I-Grebot/elec_igreplane/doc/pictures/backplane_boards.png

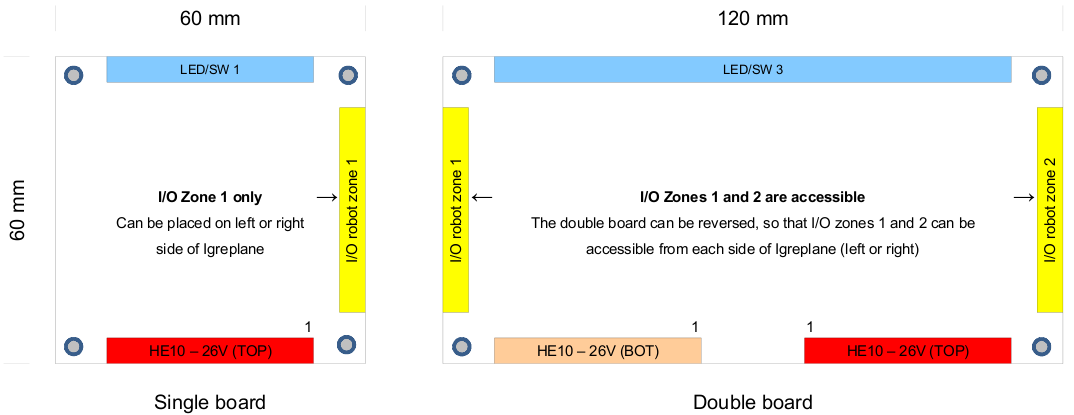
doc/pictures/backplane_boards.png
