I-Grebot/elec_igreplane/doc/pictures/backplane_connector_pinout.png

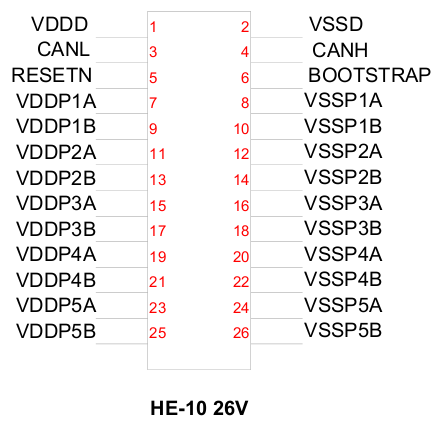
doc/pictures/backplane_connector_pinout.png
