I-Grebot/elec_igreplane/doc/pictures/backplane_layout.png

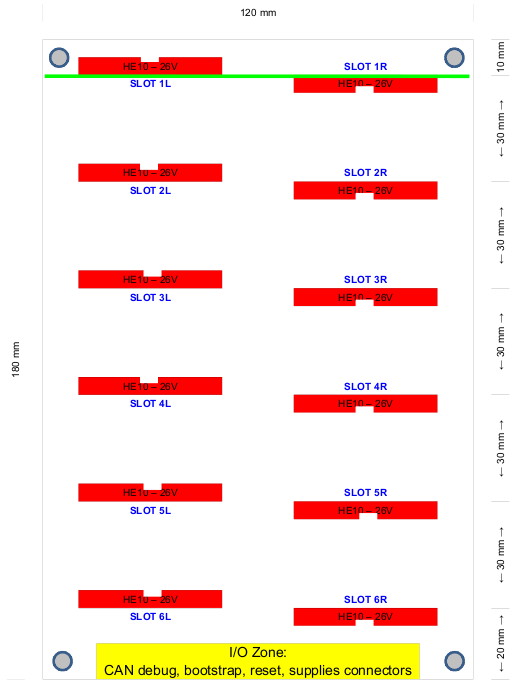
doc/pictures/backplane_layout.png
