I-Grebot/elec_igreplane/pic/eurobot.bmp

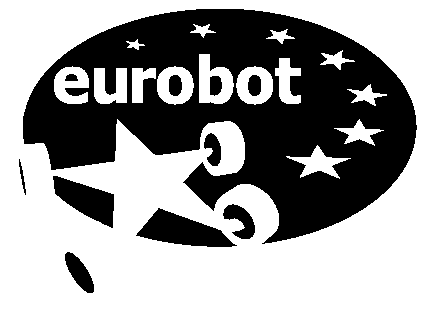
pic/eurobot.bmp
