I-Grebot/elec_igreplane/doc/igreplane_specifications.ods

Sheet: Backplane_layout
IGREBOT 2012
Backplane layout
Drawing grid is 5 mm
 |  | 120 mm
 | 180 mm |  |  |  |  | 10 mm | Notes: | The white rectangle at the connector's top represent the HE-10 slot
 |  |  | HE10 – 26V |  | SLOT 1R |  |  | The board's HE-10 connectors are female
 |  |  | SLOT 1L |  | HE10 – 26V | ← 30 mm → |  | The green line represent a double size board and its position when slotted into the backplane
 |  |  |  |  |  |  |  | The four grey dots represent the Igreplane board holes
 |  |  |  |  |  |  |  |  | located in each corner at 5mm from both edges and with a diameter of 5mm
 |  |  | HE10 – 26V |  | SLOT 2R
 |  |  | SLOT 2L |  | HE10 – 26V | ← 30 mm →
 |  |  | HE10 – 26V |  | SLOT 3R
 |  |  | SLOT 3L |  | HE10 – 26V | ← 30 mm →
 |  |  | HE10 – 26V |  | SLOT 4R
 |  |  | SLOT 4L |  | HE10 – 26V | ← 30 mm →
 |  |  | HE10 – 26V |  | SLOT 5R
 |  |  | SLOT 5L |  | HE10 – 26V | ← 30 mm →
 |  |  | HE10 – 26V |  | SLOT 6R
 |  |  | SLOT 6L |  | HE10 – 26V | ← 20 mm →
 |  |  |  | I/O Zone:
 |  |  |  | CAN debug, bootstrap, reset, supplies connectors

Sheet: Backplane_connector
IGREBOT 2012
Backplane connector
 | Pinout: |  |  |  |  |  |  |  |  |  | Conventions: |  |  | VSS* : Negative rail of power supply
 |  |  |  |  |  |  |  |  |  |  |  |  |  | VDD* : Positive rail of power supply
 |  |  | VDDD |  |  | 1 | 2 |  | VSSD |  |  |  |  | *N : Indicates a digital signal active low
 |  |  | CANL |  |  | 3 | 4 |  | CANH
 |  | RESETN |  |  |  | 5 | 6 |  |  | BOOTSTRAP
 |  |  |  | VDDP1A |  | 7 | 8 | VSSP1A |  |  | Parts references
 |  |  |  | VDDP1B |  | 9 | 10 | VSSP1B
 |  |  |  | VDDP2A |  | 11 | 12 | VSSP2A |  |  |  | * Female header for backbone
 |  |  |  | VDDP2B |  | 13 | 14 | VSSP2B |  |  |  |  | Manufacturer |  | WUERTH ELEKTRONIK
 |  |  |  | VDDP3A |  | 15 | 16 | VSSP3A |  |  |  |  | Serie |  | WR-PHD
 |  |  |  | VDDP3B |  | 17 | 18 | VSSP3B |  |  |  |  | Description |  | 2.54MM DUAL S. HEADER BOTTOM ENTRY LARGE, 26 WAYS
 |  |  |  | VDDP4A |  | 19 | 20 | VSSP4A |  |  |  |  | Manufacturer ref. |  | 613026216921
 |  |  |  | VDDP4B |  | 21 | 22 | VSSP4B |  |  |  |  | Farnell ref. |  | None
 |  |  |  | VDDP5A |  | 23 | 24 | VSSP5A
 |  |  |  | VDDP5B |  | 25 | 26 | VSSP5B |  |  |  | * Angled male header for boards
 |  |  |  |  |  |  |  |  |  |  |  |  | Manufacturer |  | WUERTH ELEKTRONIK
 |  |  |  |  |  |  |  |  |  |  |  |  | Serie |  | WR-BHD
 |  |  |  |  | HE-10 26V |  |  |  |  |  |  |  | Description |  | 2.54MM MALE ANGLED BOX HEADER, 26 WAYS
 |  |  |  |  |  |  |  |  |  |  |  |  | Manufacturer ref. |  | 61202621721
 |  |  |  |  |  |  |  |  |  |  |  |  | Farnell ref. |  | 1642026
 |  |  |  |  |  |  |  |  |  |  | Important notice:
 |  |  |  |  |  |  |  |  |  |  |  | Positions are indicated accordingly to the datasheets footprints,
 |  |  |  |  |  |  |  |  |  |  |  | as their consistency has been checked and is conform to the HE-10 standard.

Sheet: Boards_specs
IGREBOT 2012
Boards specifications
Drawing grid is 5 mm
 |  | 60 mm |  |  |  |  |  |  | 120 mm
 | 60 mm |  | LED/SW 1 |  |  |  |  |  |  |  | LED/SW 3
 |  |  |  |  |  |  |  | I/O robot zone 1 | I/O robot zone 1 |  |  |  |  |  | I/O robot zone 2
 |  |  | I/O Zone 1 only |  |  |  | → |  |  | ← | I/O Zones 1 and 2 are accessible |  |  | →
 |  |  | Can be placed on left or right |  |  |  |  |  |  |  | The double board can be reversed, so that I/O zones 1 and 2 can be
 |  |  | side of Igreplane |  |  |  |  |  |  |  | accessible from each side of Igreplane (left or right)
 |  |  |  |  |  | 1 |  |  |  |  |  | 1 | 1
 |  |  | HE10 – 26V (TOP) |  |  |  |  |  |  |  | HE10 – 26V (BOT) |  | HE10 – 26V (TOP)
 |  | Single board |  |  |  |  |  |  | Double board
 |  | Notes: |  | Boards are viewed from the top, if a specific mention (TOP) or (BOT) appears, the dedicated area is only present on the referenced side.
 |  |  |  | Usage of 1 or 2 specific backplane connector (see references on dedicated tab)
 |  |  |  | The grey dots represent on each board 4 holes, diameter of 3 mm, placed at 3 mm of the board's edges, in each corner.
 |  |  |  | Each board shall embed a dedicated 4 way DIP switch that allows to set its ID for bootload or address operations
 |  |  |  |  | (this switch might also be “solder-bridged” directly)
 |  |  |  | In case of space for I/O connectors, it is recommended to place them as close as possible to the boards edges and its I/O zone(s)
 |  |  |  |  | in order to facilitate the board's “plug'n playibility”

Sheet: Boards_assignation
IGREBOT 2012
Boards assignation
 | L | R
1 | IGREBRAIN
2
3 | IGREVATOR
4 | IGRESIVE
5 | IGRESUPPLY 2/2
6 | IGRESUPPLY 1/2
Board |  | Type | Slot
Igresupply |  | Double | 6 & 5
Igresive |  | Double | 4
Igrevator |  | Double | 3
Igrebrain |  | Single | 1L
Igrecon |  | N/A | N/A

Sheet: Power_supplies
IGREBOT 2012
Power supplies
Component |  |  |  | Actuator |  |  | Voltage |  | Amps needed |  | Value from
2x2 digital servos for grippers |  |  |  | CDS5500 |  |  | +8V |  | 5,2 |  | Datasheet
2x2 vacuum pumps for grippers |  |  |  | DC motor |  |  | +12V |  | 3,2 |  | Measurement (steady consumption, vacuuming or not)
2x elevator motors |  |  |  | DC motor |  |  | +12V |  | 1 |  | Datasheet
1x treadmill motor |  |  |  | DC motor |  |  | +12V |  | 1 |  | Pifometre
2x fingers for sides (servos) |  |  |  | ??? |  |  | +5V |  | 1 |  | Pifometre
1x beacon motor |  |  |  | Brushless motor |  |  | +12V |  | 0,5 |  | Measurement
2x beacon laser |  |  |  | Laser |  |  | +12V |  | 0,1 |  | Datasheet
8x IR avoidance sensors |  |  |  | Sharp |  |  | +5V |  | 0,16 |  | Pifometre
2x US avoidance sensors |  |  |  | SRF04 |  |  | +5V |  | 0,1 |  | Datasheet
2x Stepper motors |  |  |  | stepper motor |  |  | +12V |  | 3 |  | Pifometre
Note: Propulsion power supplies (from Igresupply to Igreversive) are not present on the backplane
 | These supplies are wired directly using boards I/Os, are they are specific and unneeded by other boards.
Board |  | VD (+5V) | VP1 (+5V) |  | VP2 (+8V) | VP3 (+12V) |  | VP4 (+12V) |  | VP5 (+12V)
Igresupply |  | 3 | 6 |  | 6 | 6 |  | 6 |  | 6
Igreversive |  | -0,2 | -0,26 |  | 0 | 0 |  | 0 |  | 0
Igrevator |  | -0,1 | -1 |  | -5,2 | -5,2 |  | 0 |  | -3
Igrebrain |  | -0,2 | 0 |  | 0 | 0 |  | 0 |  | 0
Igrecon |  | -0,2 | 0 |  | 0 | 0 |  | -0,6 |  | 0
 | Balance: | 2,3 | 4,74 |  | 0,8 | 0,8 |  | 5,4 |  | 3
