I-Grebot/elec_igreplane/pdf/igreplane_bot.pdf

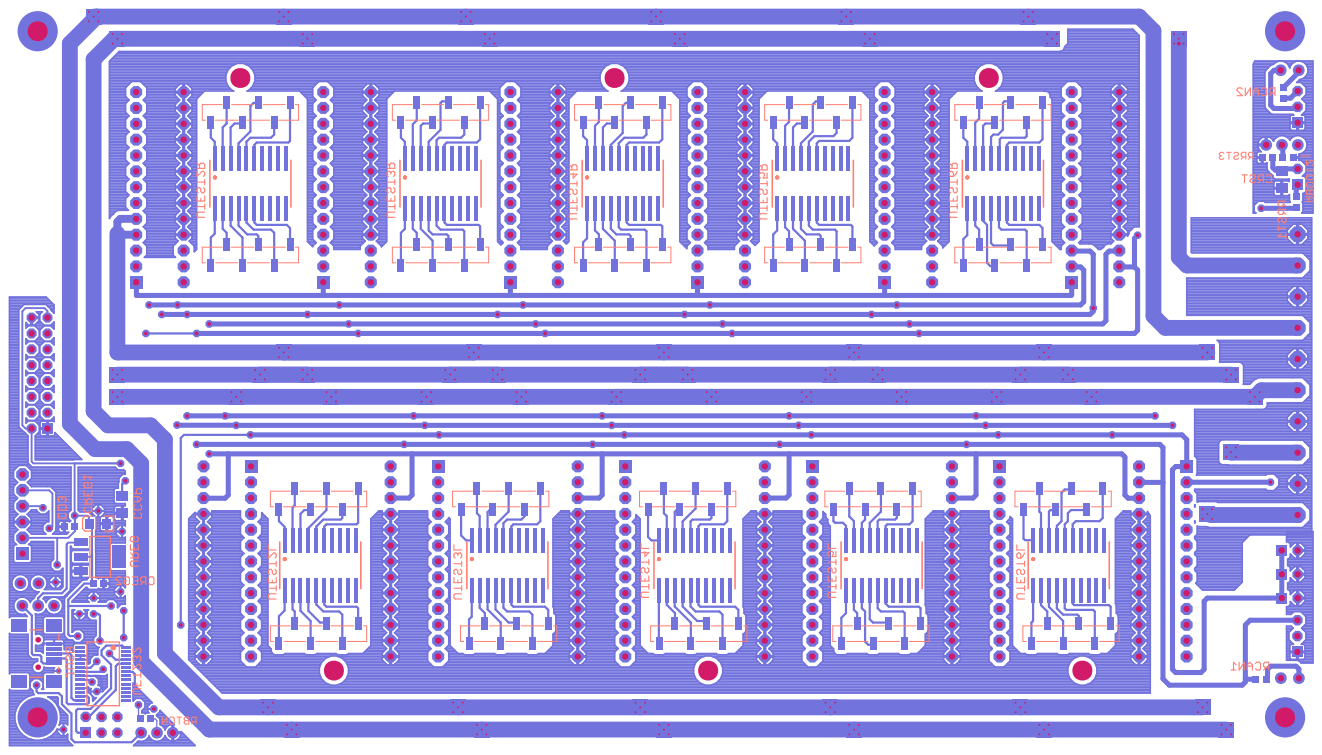
[picture p5: page 1]
