I-Grebot/elec_igreplane/pdf/igreplane_top.pdf

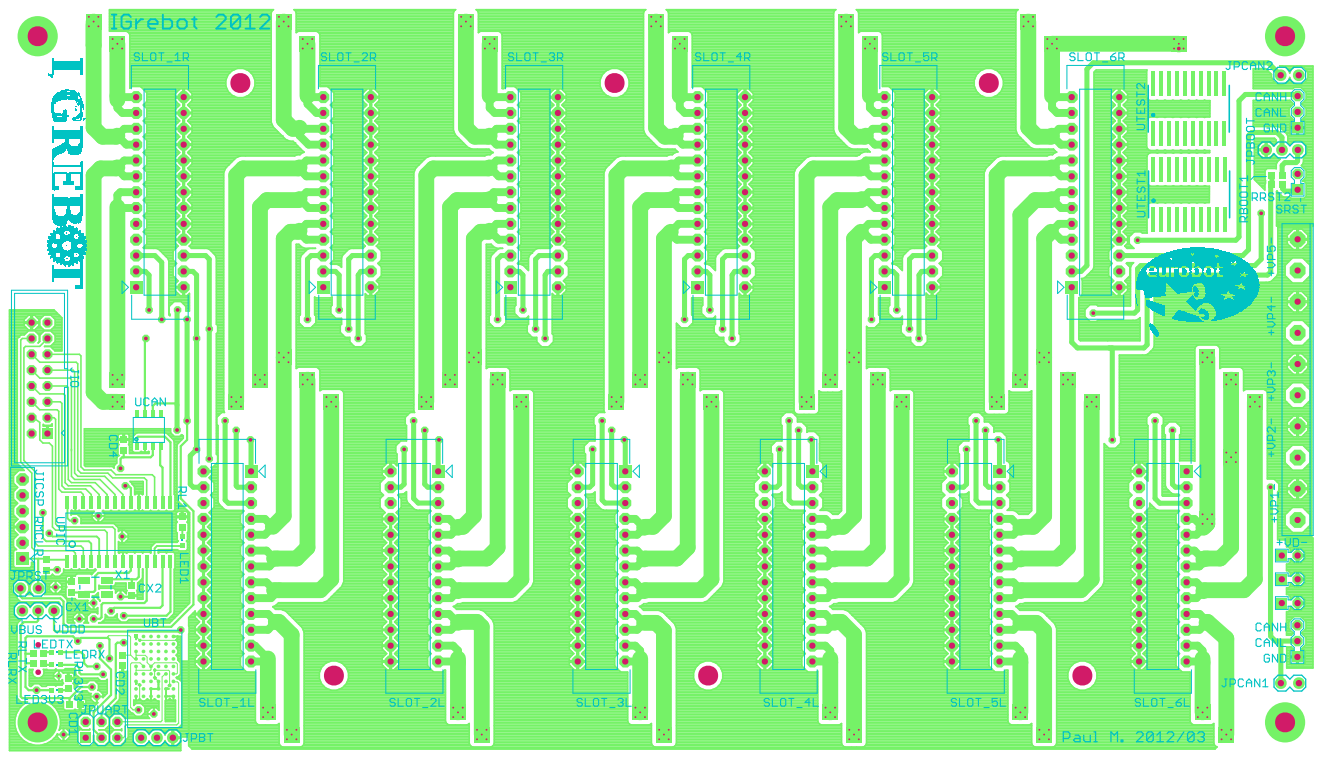
[picture p6: page 1]
