I-Grebot/elec_igreplane/sch/IGreplane/igreplane.brd

## EAGLE design sch/IGreplane/igreplane.brd (2016-06-12)

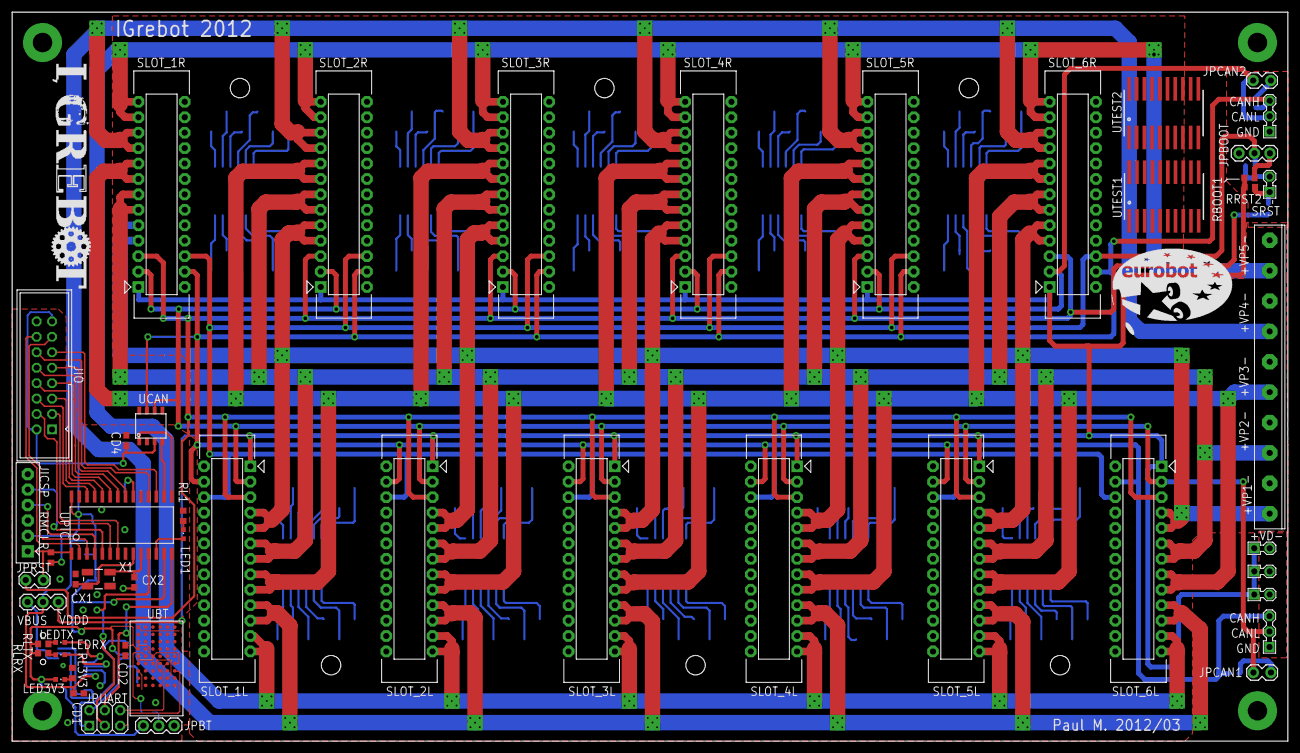
[picture p7: board igreplane.brd from above]

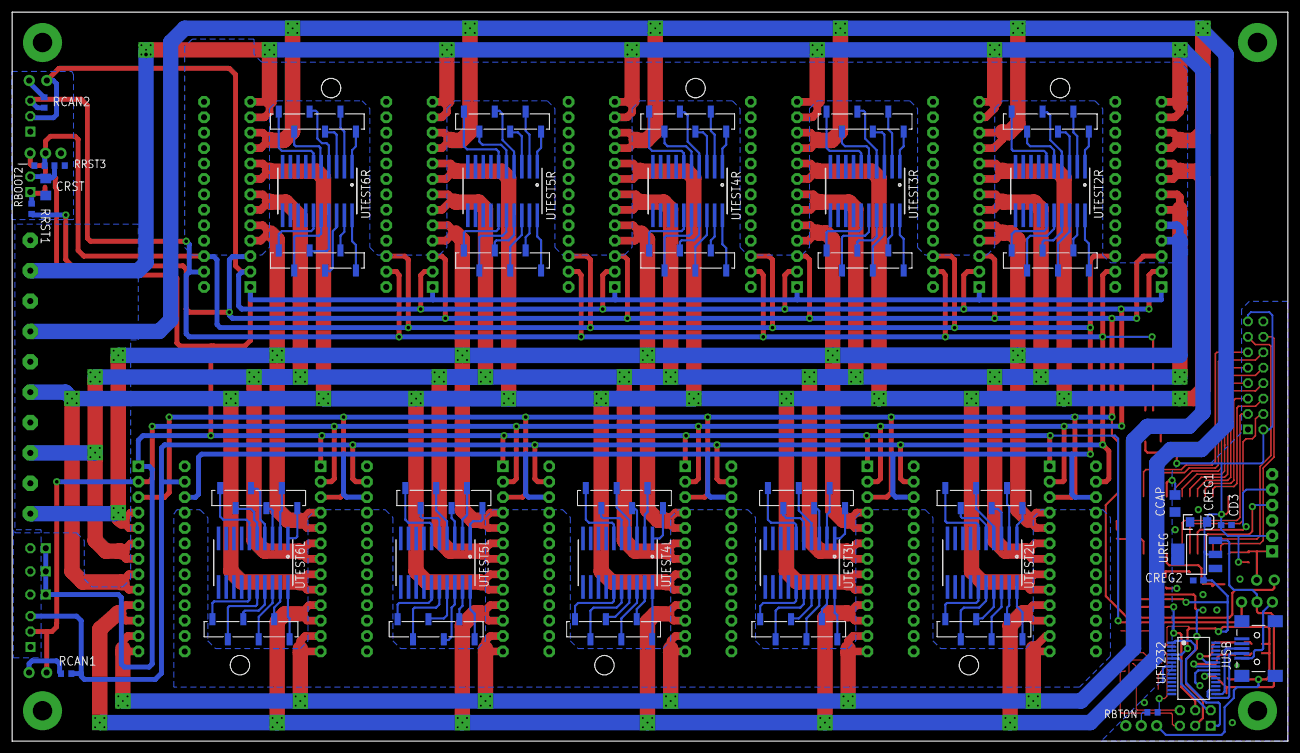
[picture p8: board igreplane.brd from below]

Board: 2 copper layers, 210.0 x 120.0 mm, 151 parts (44 on the bottom side), 176 nets.

Parts:
CCAP: 10uF; C1206
CD1, CD2, CD3, CD4: 100nF; C0603
CREG1: 10uF; EIA3216
CREG2: 220nF; C0603
CRST: 100nF; C1206
CX1, CX2: 22pF; C0603
JCAN1, JCAN2: SIL3; CON3-2.54
JICSP: PICKIT_H
JIO: HE10-16; CON-HE10-16-2.54
JPBOOT: JUMPER-3PTH; 1X03
JPBT: JUMPER-3PTH; 1X03
JPCAN1, JPCAN2: 1X02_LOCK
JPRST: 1X02_LOCK
JPUART: SIL2X3; CON2X3-2.54
JPVUSB: JUMPER-3PTH; 1X03
JTEST2L1, JTEST2L2, JTEST2R1, JTEST2R2, JTEST3L1, JTEST3L2, JTEST3R1, JTEST3R2, JTEST4L1, JTEST4L2, JTEST4R1, JTEST4R2, JTEST5L1, JTEST5R1, JTEST5R2, JTEST6L1, JTEST6R1, JTEST6R2, JTEST25L2, JTEST26L2: 1X06_SMD_STRAIGHT_ALT
JUSB: USBSMD; USB-MINIB
JVDDD1, JVDDD2, JVDDD3: SIL2; CON2-2.54
JVDDP: MULTICOMP_PA001-10; CON10-5.00
LED1, LED3V3: CHIPLED_0603
LEDRX: CHIPLED_0603
LEDTX: CHIPLED_0603
RBOOT1: 2k7; R0603
RBOOT2: 4k7; R0603
RBTON: 3.3k; R0603
RCAN1, RCAN2: 120; R0603
RL1, RL3V3: 270; R0603
RLRX: 270; R0603
RLTX: 270; R0603
RMCLR: 4.7k; R0603
RRST1: 100; R0603
RRST2: 2k7; R0603
RRST3: 4.7k; R0603
SLOT_1L, SLOT_1R, SLOT_2L, SLOT_2R, SLOT_3L, SLOT_3R, SLOT_4L, SLOT_4R, SLOT_5L, SLOT_5R, SLOT_6L, SLOT_6R: CON_IGREPLANE_SOCKET; CON_WURTH_6130_26_216921
SRST: SIL2; CON2-2.54
U$1, U$2, U$3, U$4, U$5, U$6, U$7, U$8, U$9, U$10, U$11, U$12, U$13, U$14, U$15, U$16, U$17, U$18, U$19, U$20, U$21, U$22, U$23, U$24, U$25, U$26, U$27, U$28, U$29, U$30, U$31, U$32, U$33, U$34, U$35, U$37, U$38, U$39, U$40, U$41, U$42, U$43, U$44, U$45, U$46, U$47, U$48, U$49, U$50, U$51, U$52, U$53, U$54, U$55, U$56, U$57, U$58: VIA-5_0.3
UBT: PANASONIC_PAN1321-SPP; BGA53_PAN1321-SSP
UCAN: SN65HVD231Q; SOIC8
UFT232: FT232RL; SSOP28
UPIC: DSPIC33FJ128MC802-SO; SOIC28
UREG: V_REG_317SMD; SOT223
UTEST1, UTEST2, UTEST2L, UTEST2R, UTEST3L, UTEST3R, UTEST4L, UTEST4R, UTEST5L, UTEST5R, UTEST6L, UTEST6R: SOIC_20; SO20W
X1: CRYSTAL-SMD-5X3

Connections:
!MCLR: JICSP.1, JPRST.2, RMCLR.1, UPIC.1
!RESET!: JPRST.1, RRST1.2, SLOT_1L.5, SLOT_1R.5, SLOT_2L.5, SLOT_2R.5, SLOT_3L.5, SLOT_3R.5, SLOT_4L.5, SLOT_4R.5, SLOT_5L.5, SLOT_5R.5, SLOT_6L.5, SLOT_6R.5
+3V3: CD2.1, CD3.1, CD4.1, CREG1.A, CREG2.1, JICSP.2, JIO.2, JIO.15, JPBT.1, LED3V3.A, RLRX.2, RLTX.2, RMCLR.2, UBT.A3, UBT.A4, UBT.A5, UBT.A6, UBT.C5, UBT.F6, UCAN.3, UFT232.4, UPIC.13, UPIC.28, UREG.2
BOOTSTRAP: JPBOOT.2, RBOOT2.2, SLOT_1L.6, SLOT_1R.6, SLOT_2L.6, SLOT_2R.6, SLOT_3L.6, SLOT_3R.6, SLOT_4L.6, SLOT_4R.6, SLOT_5L.6, SLOT_5R.6, SLOT_6L.6, SLOT_6R.6
BT_ON: RBTON.1, UBT.B5
BT_RXD: JPUART.6, UBT.E6
BT_TXD: JPUART.5, UBT.F7
CANH: JCAN1.3, JCAN2.3, RCAN1.1, RCAN2.1, SLOT_1L.4, SLOT_1R.4, SLOT_2L.4, SLOT_2R.4, SLOT_3L.4, SLOT_3R.4, SLOT_4L.4, SLOT_4R.4, SLOT_5L.4, SLOT_5R.4, SLOT_6L.4, SLOT_6R.4, UCAN.7
CANL: JCAN1.2, JCAN2.2, JPCAN1.2, JPCAN2.2, SLOT_1L.3, SLOT_1R.3, SLOT_2L.3, SLOT_2R.3, SLOT_3L.3, SLOT_3R.3, SLOT_4L.3, SLOT_4R.3, SLOT_5L.3, SLOT_5R.3, SLOT_6L.3, SLOT_6R.3, UCAN.6
CAN_RXD: UCAN.4, UPIC.16
CAN_TXD: UCAN.1, UPIC.15
FTDI_RXD: JPUART.2, UFT232.5
FTDI_TXD: JPUART.1, UFT232.1
GND: CCAP.2, CD1.2, CD2.2, CD3.2, CD4.2, CREG1.C, CREG2.2, CRST.2, CX1.2, CX2.2, JCAN1.1, JCAN2.1, JICSP.3, JIO.1, JIO.16, JPBOOT.3, JPBT.3, JUSB.GND, JVDDD1.2, JVDDD2.2, JVDDD3.2, JVDDP.2, JVDDP.4, JVDDP.6, JVDDP.8, JVDDP.10, RBOOT2.1, RL1.1, RL3V3.1, RRST3.1, SLOT_1L.2, SLOT_1L.8, SLOT_1L.10, SLOT_1L.12, SLOT_1L.14, SLOT_1L.16, SLOT_1L.18, SLOT_1L.20, SLOT_1L.22, SLOT_1L.24, SLOT_1L.26, SLOT_1R.2, SLOT_1R.8, SLOT_1R.10, SLOT_1R.12, SLOT_1R.14, SLOT_1R.16, SLOT_1R.18, SLOT_1R.20, SLOT_1R.22, SLOT_1R.24, SLOT_1R.26, SLOT_2L.2, SLOT_2L.8, SLOT_2L.10, SLOT_2L.12, SLOT_2L.14, SLOT_2L.16, SLOT_2L.18, SLOT_2L.20, SLOT_2L.22, SLOT_2L.24, SLOT_2L.26, SLOT_2R.2, SLOT_2R.8, SLOT_2R.10, SLOT_2R.12, SLOT_2R.14, SLOT_2R.16, SLOT_2R.18, SLOT_2R.20, SLOT_2R.22, SLOT_2R.24, SLOT_2R.26, SLOT_3L.2, SLOT_3L.8, SLOT_3L.10, SLOT_3L.12, SLOT_3L.14, SLOT_3L.16, SLOT_3L.18, SLOT_3L.20, SLOT_3L.22, SLOT_3L.24, SLOT_3L.26, SLOT_3R.2, SLOT_3R.8, SLOT_3R.10, SLOT_3R.12, SLOT_3R.14, SLOT_3R.16, SLOT_3R.18, SLOT_3R.20, SLOT_3R.22, SLOT_3R.24, SLOT_3R.26, SLOT_4L.2, SLOT_4L.8, SLOT_4L.10, SLOT_4L.12, SLOT_4L.14, SLOT_4L.16, SLOT_4L.18, SLOT_4L.20, SLOT_4L.22, SLOT_4L.24, SLOT_4L.26, SLOT_4R.2, SLOT_4R.8, SLOT_4R.10, SLOT_4R.12, SLOT_4R.14, SLOT_4R.16, SLOT_4R.18, SLOT_4R.20, SLOT_4R.22, SLOT_4R.24, SLOT_4R.26, SLOT_5L.2, SLOT_5L.8, SLOT_5L.10, SLOT_5L.12, SLOT_5L.14, SLOT_5L.16, SLOT_5L.18, SLOT_5L.20, SLOT_5L.22, SLOT_5L.24, SLOT_5L.26, SLOT_5R.2, SLOT_5R.8, SLOT_5R.10, SLOT_5R.12, SLOT_5R.14, SLOT_5R.16, SLOT_5R.18, SLOT_5R.20, SLOT_5R.22, SLOT_5R.24, SLOT_5R.26, SLOT_6L.2, SLOT_6L.8, SLOT_6L.10, SLOT_6L.12, SLOT_6L.14, SLOT_6L.16, SLOT_6L.18, SLOT_6L.20, SLOT_6L.22, SLOT_6L.24, SLOT_6L.26, SLOT_6R.2, SLOT_6R.8, SLOT_6R.10, SLOT_6R.12, SLOT_6R.14, SLOT_6R.16, SLOT_6R.18, SLOT_6R.20, SLOT_6R.22, SLOT_6R.24, SLOT_6R.26, UBT.A1, UBT.A7, UBT.A9, UBT.C8, UBT.C9, UBT.D7, UBT.D8, UBT.E8, UBT.E9, UBT.F1, UBT.F9, UCAN.2, UFT232.7, UFT232.18, UFT232.21, UFT232.25, UFT232.26, UPIC.8, UPIC.19, UPIC.27, UREG.1
IO1: JIO.3, UPIC.7
IO2: JIO.4, UPIC.6
IO3: JIO.5, UPIC.25
IO4: JIO.6, UPIC.26
IO5: JIO.7, UPIC.23
IO6: JIO.8, UPIC.24
IO7: JIO.9, UPIC.21
IO8: JIO.10, UPIC.22
IO9: JIO.11, UPIC.17
IO10: JIO.12, UPIC.18
IO11: JIO.13, UPIC.3
IO12: JIO.14, UPIC.2
LED1: LED1.A, UPIC.12
unnamed: JPCAN1.1, RCAN1.2
unnamed: CRST.1, RRST3.2, SRST.2
unnamed: RRST1.1, RRST2.1, SRST.1
unnamed: JPCAN2.1, RCAN2.2
unnamed: LEDTX.C, UFT232.23
unnamed: JPBOOT.1, RBOOT1.1
unnamed: LEDRX.C, UFT232.22
unnamed: LEDTX.A, RLTX.1
unnamed: LEDRX.A, RLRX.1
unnamed: LED1.C, RL1.2
unnamed: LED3V3.C, RL3V3.2
unnamed: JPBT.2, RBTON.2
unnamed: JTEST6R2.1, UTEST6R.P$20
unnamed: JTEST6R2.2, UTEST6R.P$19
unnamed: JTEST6R2.3, UTEST6R.P$18
unnamed: JTEST6R2.4, UTEST6R.P$17
unnamed: JTEST6R2.5, UTEST6R.P$16
unnamed: JTEST6R2.6, UTEST6R.P$15
unnamed: JTEST6R1.1, UTEST6R.P$6
unnamed: JTEST6R1.2, UTEST6R.P$5
unnamed: JTEST6R1.3, UTEST6R.P$4
unnamed: JTEST6R1.4, UTEST6R.P$3
unnamed: JTEST6R1.5, UTEST6R.P$2
unnamed: JTEST6R1.6, UTEST6R.P$1
unnamed: JTEST5R2.1, UTEST5R.P$20
unnamed: JTEST5R2.2, UTEST5R.P$19
unnamed: JTEST5R2.3, UTEST5R.P$18
unnamed: JTEST5R2.4, UTEST5R.P$17
unnamed: JTEST5R2.5, UTEST5R.P$16
unnamed: JTEST5R2.6, UTEST5R.P$15
unnamed: JTEST5R1.1, UTEST5R.P$6
unnamed: JTEST5R1.2, UTEST5R.P$5
unnamed: JTEST5R1.3, UTEST5R.P$4
unnamed: JTEST5R1.4, UTEST5R.P$3
unnamed: JTEST5R1.5, UTEST5R.P$2
unnamed: JTEST5R1.6, UTEST5R.P$1
unnamed: JTEST4R2.1, UTEST4R.P$20
unnamed: JTEST4R2.2, UTEST4R.P$19
unnamed: JTEST4R2.3, UTEST4R.P$18
unnamed: JTEST4R2.4, UTEST4R.P$17
unnamed: JTEST4R2.5, UTEST4R.P$16
unnamed: JTEST4R2.6, UTEST4R.P$15
unnamed: JTEST4R1.1, UTEST4R.P$6
unnamed: JTEST4R1.2, UTEST4R.P$5
unnamed: JTEST4R1.3, UTEST4R.P$4
unnamed: JTEST4R1.4, UTEST4R.P$3
unnamed: JTEST4R1.5, UTEST4R.P$2
unnamed: JTEST4R1.6, UTEST4R.P$1
unnamed: JTEST3R2.1, UTEST3R.P$20
unnamed: JTEST3R2.2, UTEST3R.P$19
unnamed: JTEST3R2.3, UTEST3R.P$18
unnamed: JTEST3R2.4, UTEST3R.P$17
unnamed: JTEST3R2.5, UTEST3R.P$16
unnamed: JTEST3R2.6, UTEST3R.P$15
unnamed: JTEST3R1.1, UTEST3R.P$6
unnamed: JTEST3R1.2, UTEST3R.P$5
unnamed: JTEST3R1.3, UTEST3R.P$4
unnamed: JTEST3R1.4, UTEST3R.P$3
unnamed: JTEST3R1.5, UTEST3R.P$2
unnamed: JTEST3R1.6, UTEST3R.P$1
unnamed: JTEST2R2.1, UTEST2R.P$20
unnamed: JTEST2R2.2, UTEST2R.P$19
unnamed: JTEST2R2.3, UTEST2R.P$18
unnamed: JTEST2R2.4, UTEST2R.P$17
unnamed: JTEST2R2.5, UTEST2R.P$16
unnamed: JTEST2R2.6, UTEST2R.P$15
unnamed: JTEST2R1.1, UTEST2R.P$6
unnamed: JTEST2R1.2, UTEST2R.P$5
unnamed: JTEST2R1.3, UTEST2R.P$4
unnamed: JTEST2R1.4, UTEST2R.P$3
unnamed: JTEST2R1.5, UTEST2R.P$2
unnamed: JTEST2R1.6, UTEST2R.P$1
unnamed: JTEST2L1.1, UTEST2L.P$6
unnamed: JTEST2L1.2, UTEST2L.P$5
unnamed: JTEST2L1.3, UTEST2L.P$4
unnamed: JTEST2L1.4, UTEST2L.P$3
unnamed: JTEST2L1.5, UTEST2L.P$2
unnamed: JTEST2L1.6, UTEST2L.P$1
unnamed: JTEST3L1.1, UTEST3L.P$6
unnamed: JTEST3L1.2, UTEST3L.P$5
unnamed: JTEST3L1.3, UTEST3L.P$4
unnamed: JTEST3L1.4, UTEST3L.P$3
unnamed: JTEST3L1.5, UTEST3L.P$2
unnamed: JTEST3L1.6, UTEST3L.P$1
unnamed: JTEST4L1.1, UTEST4L.P$6
unnamed: JTEST4L1.2, UTEST4L.P$5
unnamed: JTEST4L1.3, UTEST4L.P$4
unnamed: JTEST4L1.4, UTEST4L.P$3
unnamed: JTEST4L1.5, UTEST4L.P$2
unnamed: JTEST4L1.6, UTEST4L.P$1
unnamed: JTEST5L1.1, UTEST5L.P$6
unnamed: JTEST5L1.2, UTEST5L.P$5
unnamed: JTEST5L1.3, UTEST5L.P$4
unnamed: JTEST5L1.4, UTEST5L.P$3
unnamed: JTEST5L1.5, UTEST5L.P$2
unnamed: JTEST5L1.6, UTEST5L.P$1
unnamed: JTEST6L1.1, UTEST6L.P$6
unnamed: JTEST6L1.2, UTEST6L.P$5
unnamed: JTEST6L1.3, UTEST6L.P$4
unnamed: JTEST6L1.4, UTEST6L.P$3
unnamed: JTEST6L1.5, UTEST6L.P$2
unnamed: JTEST6L1.6, UTEST6L.P$1
unnamed: JTEST2L2.1, UTEST2L.P$20
unnamed: JTEST2L2.2, UTEST2L.P$19
unnamed: JTEST2L2.3, UTEST2L.P$18
unnamed: JTEST2L2.4, UTEST2L.P$17
unnamed: JTEST2L2.5, UTEST2L.P$16
unnamed: JTEST2L2.6, UTEST2L.P$15
unnamed: JTEST3L2.1, UTEST3L.P$20
unnamed: JTEST3L2.2, UTEST3L.P$19
unnamed: JTEST3L2.3, UTEST3L.P$18
unnamed: JTEST3L2.4, UTEST3L.P$17
unnamed: JTEST3L2.5, UTEST3L.P$16
unnamed: JTEST3L2.6, UTEST3L.P$15
unnamed: JTEST4L2.1, UTEST4L.P$20
unnamed: JTEST4L2.2, UTEST4L.P$19
unnamed: JTEST4L2.3, UTEST4L.P$18
unnamed: JTEST4L2.4, UTEST4L.P$17
unnamed: JTEST4L2.5, UTEST4L.P$16
unnamed: JTEST4L2.6, UTEST4L.P$15
unnamed: JTEST25L2.1, UTEST5L.P$20
unnamed: JTEST25L2.2, UTEST5L.P$19
unnamed: JTEST25L2.3, UTEST5L.P$18
unnamed: JTEST25L2.4, UTEST5L.P$17
unnamed: JTEST25L2.5, UTEST5L.P$16
unnamed: JTEST25L2.6, UTEST5L.P$15
unnamed: JTEST26L2.1, UTEST6L.P$20
unnamed: JTEST26L2.2, UTEST6L.P$19
unnamed: JTEST26L2.3, UTEST6L.P$18
unnamed: JTEST26L2.4, UTEST6L.P$17
unnamed: JTEST26L2.5, UTEST6L.P$16
unnamed: JTEST26L2.6, UTEST6L.P$15
OSC1: CX1.1, UPIC.9, X1.1
OSC2: CX2.1, UPIC.10, X1.3
PGC: JICSP.5, UPIC.5
PGD: JICSP.4, UPIC.4
UART_RXD: JPUART.4, UPIC.14
UART_TXD: JPUART.3, UPIC.11
USBDM: JUSB.D-, UFT232.16
USBDP: JUSB.D+, UFT232.15
VBUS: JPVUSB.1, JUSB.VBUS
VCAP: CCAP.1, UPIC.20
VDDD: JPVUSB.3, JVDDD1.1, JVDDD2.1, JVDDD3.1, RBOOT1.2, RRST2.2, SLOT_1L.1, SLOT_1R.1, SLOT_2L.1, SLOT_2R.1, SLOT_3L.1, SLOT_3R.1, SLOT_4L.1, SLOT_4R.1, SLOT_5L.1, SLOT_5R.1, SLOT_6L.1, SLOT_6R.1
VDDP1: JVDDP.1, SLOT_1L.7, SLOT_1L.9, SLOT_1R.7, SLOT_1R.9, SLOT_2L.7, SLOT_2L.9, SLOT_2R.7, SLOT_2R.9, SLOT_3L.7, SLOT_3L.9, SLOT_3R.7, SLOT_3R.9, SLOT_4L.7, SLOT_4L.9, SLOT_4R.7, SLOT_4R.9, SLOT_5L.7, SLOT_5L.9, SLOT_5R.7, SLOT_5R.9, SLOT_6L.7, SLOT_6L.9, SLOT_6R.7, SLOT_6R.9, U$25.VIA, U$26.VIA, U$27.VIA, U$28.VIA, U$29.VIA, U$30.VIA, U$57.VIA
VDDP2: JVDDP.3, SLOT_1L.11, SLOT_1L.13, SLOT_1R.11, SLOT_1R.13, SLOT_2L.11, SLOT_2L.13, SLOT_2R.11, SLOT_2R.13, SLOT_3L.11, SLOT_3L.13, SLOT_3R.11, SLOT_3R.13, SLOT_4L.11, SLOT_4L.13, SLOT_4R.11, SLOT_4R.13, SLOT_5L.11, SLOT_5L.13, SLOT_5R.11, SLOT_5R.13, SLOT_6L.11, SLOT_6L.13, SLOT_6R.11, SLOT_6R.13, U$31.VIA, U$32.VIA, U$33.VIA, U$34.VIA, U$35.VIA, U$37.VIA, U$38.VIA, U$39.VIA, U$40.VIA, U$41.VIA, U$42.VIA, U$43.VIA, U$56.VIA
VDDP3: JVDDP.5, SLOT_1L.15, SLOT_1L.17, SLOT_1R.15, SLOT_1R.17, SLOT_2L.15, SLOT_2L.17, SLOT_2R.15, SLOT_2R.17, SLOT_3L.15, SLOT_3L.17, SLOT_3R.15, SLOT_3R.17, SLOT_4L.15, SLOT_4L.17, SLOT_4R.15, SLOT_4R.17, SLOT_5L.15, SLOT_5L.17, SLOT_5R.15, SLOT_5R.17, SLOT_6L.15, SLOT_6L.17, SLOT_6R.15, SLOT_6R.17, U$44.VIA, U$45.VIA, U$46.VIA, U$47.VIA, U$48.VIA, U$49.VIA, U$50.VIA, U$51.VIA, U$52.VIA, U$53.VIA, U$54.VIA, U$55.VIA
VDDP4: JVDDP.7, SLOT_1L.19, SLOT_1L.21, SLOT_1R.19, SLOT_1R.21, SLOT_2L.19, SLOT_2L.21, SLOT_2R.19, SLOT_2R.21, SLOT_3L.19, SLOT_3L.21, SLOT_3R.19, SLOT_3R.21, SLOT_4L.19, SLOT_4L.21, SLOT_4R.19, SLOT_4R.21, SLOT_5L.19, SLOT_5L.21, SLOT_5R.19, SLOT_5R.21, SLOT_6L.19, SLOT_6L.21, SLOT_6R.19, SLOT_6R.21, U$1.VIA, U$2.VIA, U$3.VIA, U$4.VIA, U$5.VIA, U$6.VIA, U$7.VIA, U$8.VIA, U$9.VIA, U$10.VIA, U$11.VIA, U$12.VIA
VDDP5: JVDDP.9, SLOT_1L.23, SLOT_1L.25, SLOT_1R.23, SLOT_1R.25, SLOT_2L.23, SLOT_2L.25, SLOT_2R.23, SLOT_2R.25, SLOT_3L.23, SLOT_3L.25, SLOT_3R.23, SLOT_3R.25, SLOT_4L.23, SLOT_4L.25, SLOT_4R.23, SLOT_4R.25, SLOT_5L.23, SLOT_5L.25, SLOT_5R.23, SLOT_5R.25, SLOT_6L.23, SLOT_6L.25, SLOT_6R.23, SLOT_6R.25, U$13.VIA, U$14.VIA, U$15.VIA, U$16.VIA, U$17.VIA, U$18.VIA, U$19.VIA, U$20.VIA, U$21.VIA, U$22.VIA, U$23.VIA, U$24.VIA, U$58.VIA
VUSB: CD1.1, JPVUSB.2, UFT232.20, UREG.3
